Cole-Codemann/SIMD-GPU-Core/rtl/src/warp_controller.sv

module warp_controller (
    input  logic        rst,
    input  logic        clk,
    input  logic [3:0]  alu_req,
    (* MAX_FANOUT = 24 *) output logic [3:0]  alu_access
);
    typedef enum {FULL_HALT, WARP0, WARP1, WARP2, WARP3} state_t;
    state_t state, next_state;

    // ── Next State Logic ─────────────────────────────────────
    always_comb begin
        case (state)
            FULL_HALT: next_state = (alu_req[0]) ? WARP0 :
                                    (alu_req[1]) ? WARP1 :
                                    (alu_req[2]) ? WARP2 :
                                    (alu_req[3]) ? WARP3 :
                                                   FULL_HALT;
            WARP0:     next_state = (alu_req[1]) ? WARP1 :
                                    (alu_req[2]) ? WARP2 :
                                    (alu_req[3]) ? WARP3 :
                                    (alu_req[0]) ? WARP0 :
                                                   FULL_HALT;
            WARP1:     next_state = (alu_req[2]) ? WARP2 :
                                    (alu_req[3]) ? WARP3 :
                                    (alu_req[0]) ? WARP0 :
                                    (alu_req[1]) ? WARP1 :
                                                   FULL_HALT;
            WARP2:     next_state = (alu_req[3]) ? WARP3 :
                                    (alu_req[0]) ? WARP0 :
                                    (alu_req[1]) ? WARP1 :
                                    (alu_req[2]) ? WARP2 :
                                                   FULL_HALT;
            WARP3:     next_state = (alu_req[0]) ? WARP0 :
                                    (alu_req[1]) ? WARP1 :
                                    (alu_req[2]) ? WARP2 :
                                    (alu_req[3]) ? WARP3 :
                                                   FULL_HALT;
            default:   next_state = FULL_HALT;
        endcase
    end

    // ── Combination assignment of next access based on next state ────────────────────
    // alu_access deals with massive routing which is why we register is alone, then cap fanout
    logic [3:0] next_alu_access;
    
    always_comb begin
        case (next_state)
            WARP0:   next_alu_access = 4'b0001;
            WARP1:   next_alu_access = 4'b0010;
            WARP2:   next_alu_access = 4'b0100;
            WARP3:   next_alu_access = 4'b1000;
            default: next_alu_access = 4'b0000;
        endcase
    end

    // ── State Register ───────────────────────────────────────
    always_ff @(posedge clk) begin
        if (rst) begin
            state      <= FULL_HALT;
            alu_access <= 4'b0000;
        end else begin
            state      <= next_state;
            alu_access <= next_alu_access;
        end
    end
endmodule
