Cole-Codemann/SIMD-GPU-Core/(commit log)

2026-04-26 Add files via upload
    Core .sv files. Working prototype
2026-06-07 Add files via upload
    Currently used testbenches
2026-06-07 fix bug
    Fixed, from 2 cycle delay to 1
    [warp_controller.sv]
2026-06-11 Revise Status Report with current project updates
    Updated status report with new goals, progress, and challenges.
2026-07-27 init commit of shortened list of files
    [GPU_Design_wrapper.v, GPU_top.sv, GPU_top.xdc, Warp.sv, alu_lanes.sv, cu.sv, cu_tb.sv, kernel_library.c]
